PikoPikoFactory/PikoPikoBitsAlpha/Hardware/PikoPikoBitsAlpha_schematic.pdf

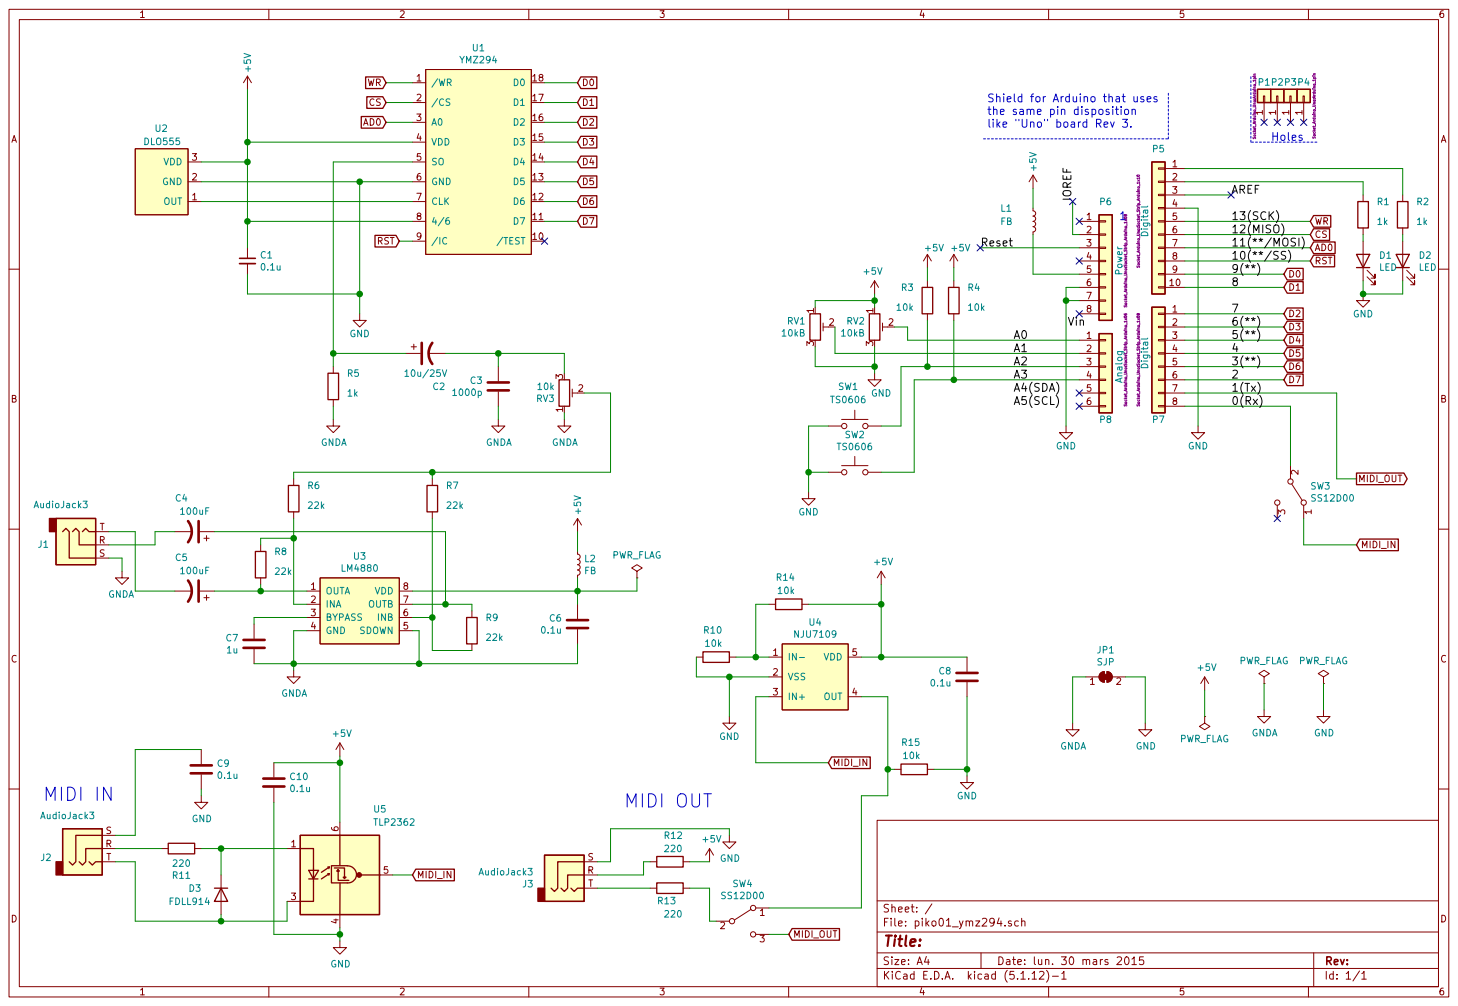
[picture p3: page 1]

Holes Shield for Arduino that uses
the same pin disposition

like "Uno" board Rev 3. MIDI OUT
